P5k-ps5/p5k-ps5/app/fuentes/LEEME.md

# Fuentes de la interfaz

Recortes al español de **Inter Tight** y **Geist Mono**, las mismas de NeuroClaude, generados con
`herramientas/fuentes.py`. Las dos tienen licencia [SIL Open Font License 1.1](https://openfontlicense.org);
el aviso de copyright y la licencia viajan dentro de cada fuente, en sus metadatos.

- `app/fuentes/*.ttf`: las carga la app de Mac.
- `escritorio/ui/fuentes/*.woff2`: las carga el instalador.
- `app/Pagina.swift`: las mismas woff2 en base64, porque la página no tiene internet garantizado.
