P5k-ps5/p5k-ps5/caja/compacta/vistas.png

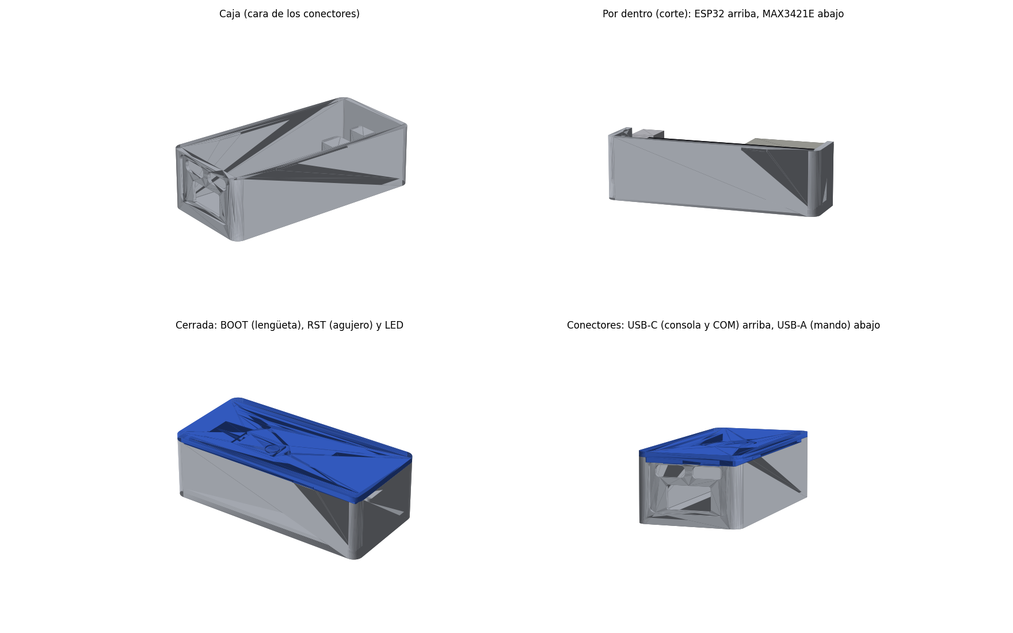
caja/compacta/vistas.png
