P5k-ps5/p5k-ps5/caja/placa/vistas.png

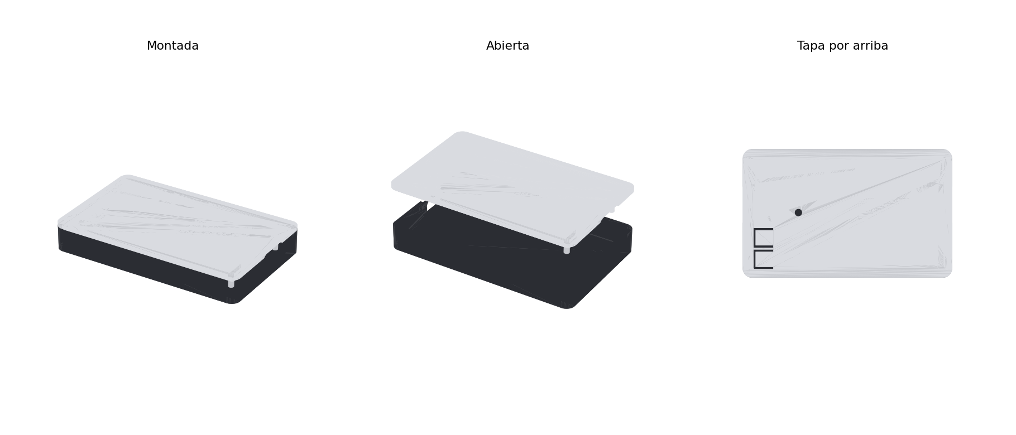
caja/placa/vistas.png
