P5k-ps5/p5k-ps5/placa/fabricacion/puente-bom.csv

Comment | Designator | Footprint | LCSC Part #
22u | C1,C2,C12,C15 | C_0805_2012Metric | C45783
100n | C3,C5,C7,C8,C13 | C_0402_1005Metric | C1525
1u | C4,C6,C9 | C_0402_1005Metric | C52923
20p | C10,C11 | C_0402_1005Metric | C1554
10u | C14 | C_0603_1608Metric | C19702
WS2812B-2020-V6 | D1 | LED_WS2812B-2020_PLCC4_2.0x2.0mm | C52917434
1N4148W | D2 | D_SOD-123 | C81598
CONSOLA/MANDO | J1,J2 | USB_C_Receptacle_HRO_TYPE-C-31-M-12 | C165948
AO3401A | Q1 | SOT-23 | C15127
2N7002 | Q2 | SOT-23 | C8545
10k | R1,R2,R3,R4,R10,R12,R15 | R_0402_1005Metric | C25744
33 | R5,R6 | R_0402_1005Metric | C25105
56k | R7,R8 | R_0402_1005Metric | C25796
100k | R9,R11 | R_0402_1005Metric | C25741
5.1k | R13,R14 | R_0402_1005Metric | C25905
BOOT/RST | SW1,SW2 | SW_Push_1P1T_XKB_TS-1187A | C318884
ESP32-S3-WROOM-1-N16R8 | U1 | ESP32-S3-WROOM-1 | C2913202
MAX3421EETJ+T | U2 | TQFN-32-1EP_5x5mm_P0.5mm_EP3.1x3.1mm | C1870151
AMS1117-3.3 | U3 | SOT-223-3_TabPin2 | C6186
USBLC6-2SC6 | U4 | SOT-23-6 | C7519
12MHz | Y1 | Crystal_SMD_3225-4Pin_3.2x2.5mm | C9002
