P5k-ps5/p5k-ps5/caja/compacta/caja-base.stl

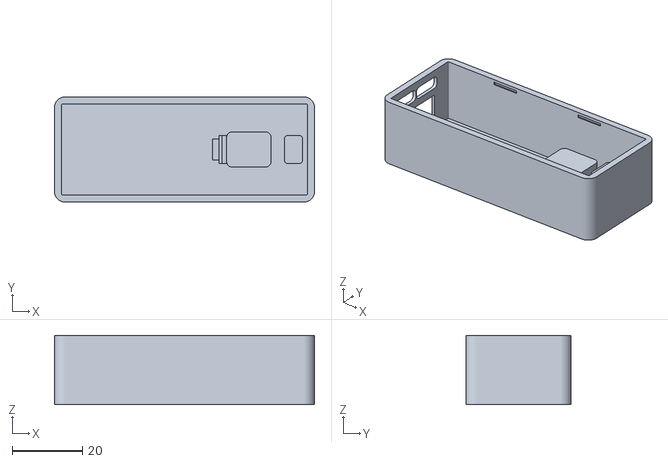
[picture p4: CAD file, 2026-11-11]
caja/compacta/caja-base.stl
74.1 x 30.0 x 19.8
