P5k-ps5/p5k-ps5/caja/conectable/caja-tapa.stl

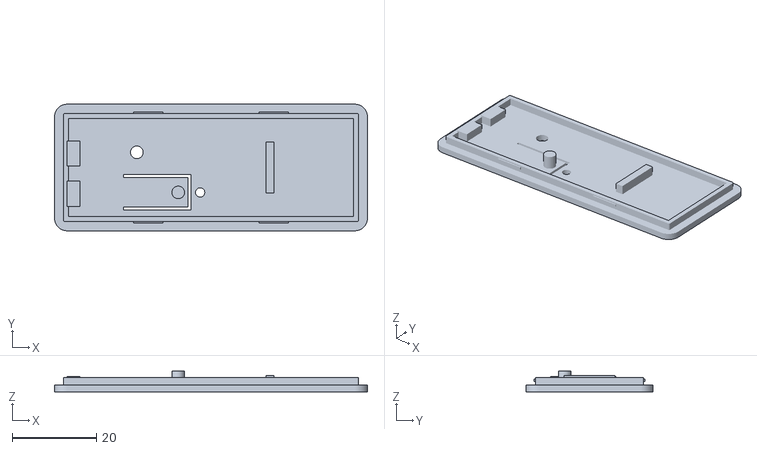
[picture p5: CAD file, 2026-11-11]
caja/conectable/caja-tapa.stl
74.1 x 30.0 x 4.90
