P5k-ps5/p5k-ps5/caja/placa/caja-tapa.stl

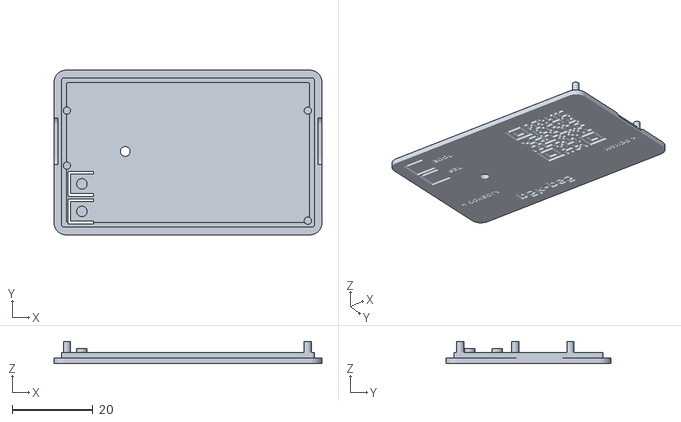
[picture p6: CAD file, 2026-11-11]
caja/placa/caja-tapa.stl
66.2 x 40.7 x 5.50
