P5k-ps5/p5k-ps5/web/descargas/modulos/caja-base.stl

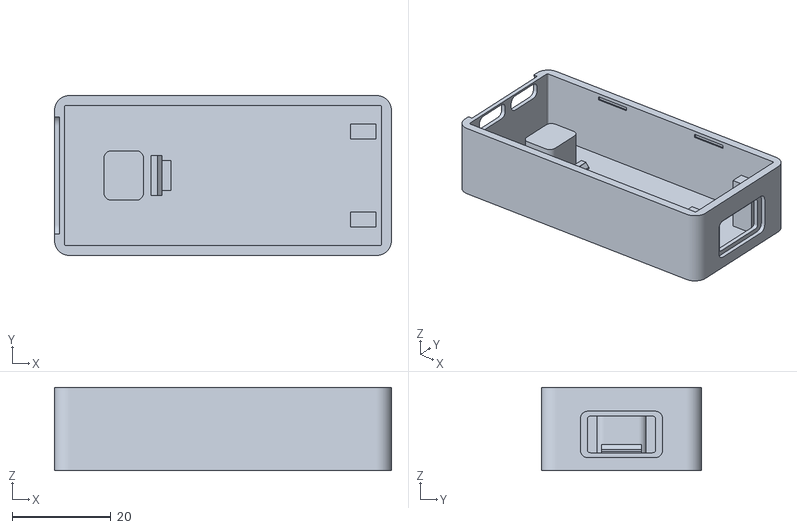
[picture p7: CAD file, 2026-11-11]
web/descargas/modulos/caja-base.stl
68.1 x 32.3 x 16.8
