P5k-ps5/p5k-ps5/web/descargas/placa/caja-base.stl

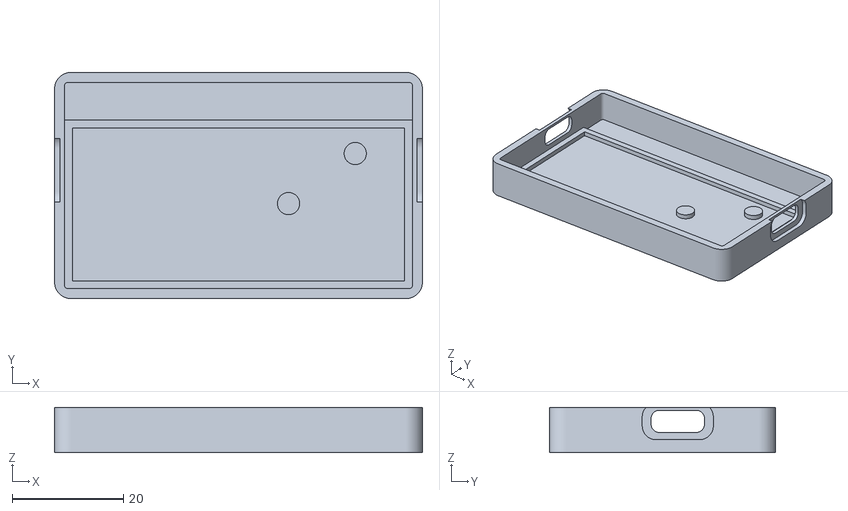
[picture p8: CAD file, 2026-11-11]
web/descargas/placa/caja-base.stl
66.2 x 40.7 x 8.10
