P5k-ps5/p5k-ps5/caja/conectable/prueba-puertos.stl

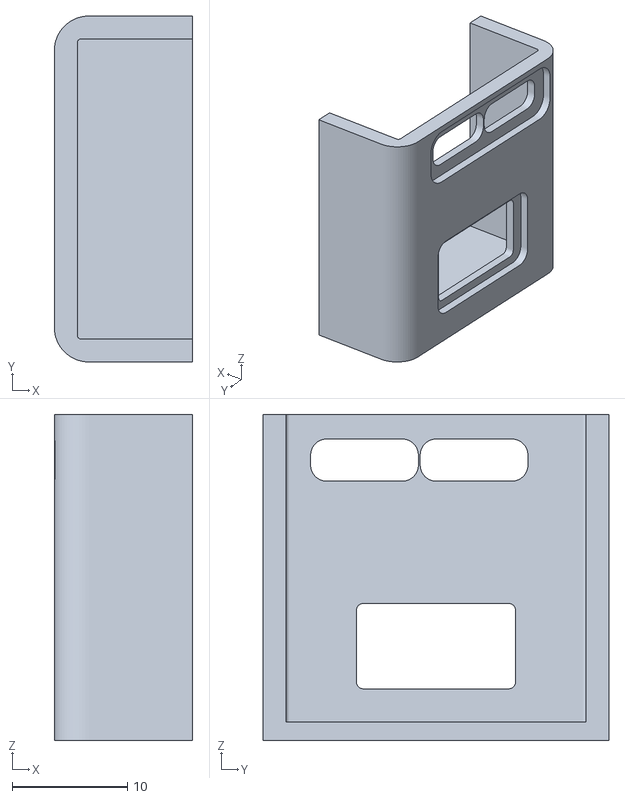
[picture p9: CAD file, 2026-11-11]
caja/conectable/prueba-puertos.stl
12.0 x 30.0 x 28.3
