P5k-ps5/p5k-ps5/web/descargas/modulos/prueba-puertos.stl

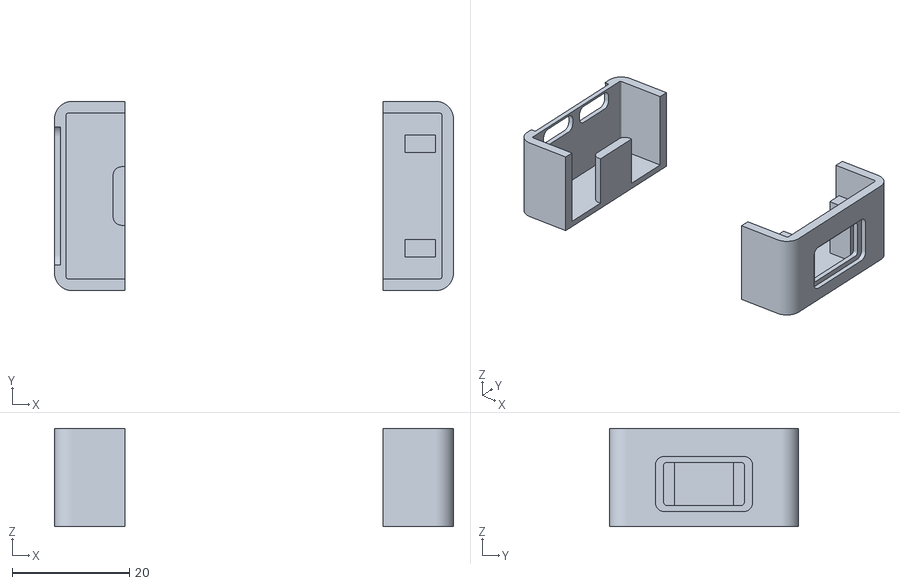
[picture p10: CAD file, 2026-11-11]
web/descargas/modulos/prueba-puertos.stl
68.1 x 32.3 x 16.8
