P5k-ps5/p5k-ps5/caja/compacta/prueba-puertos.stl

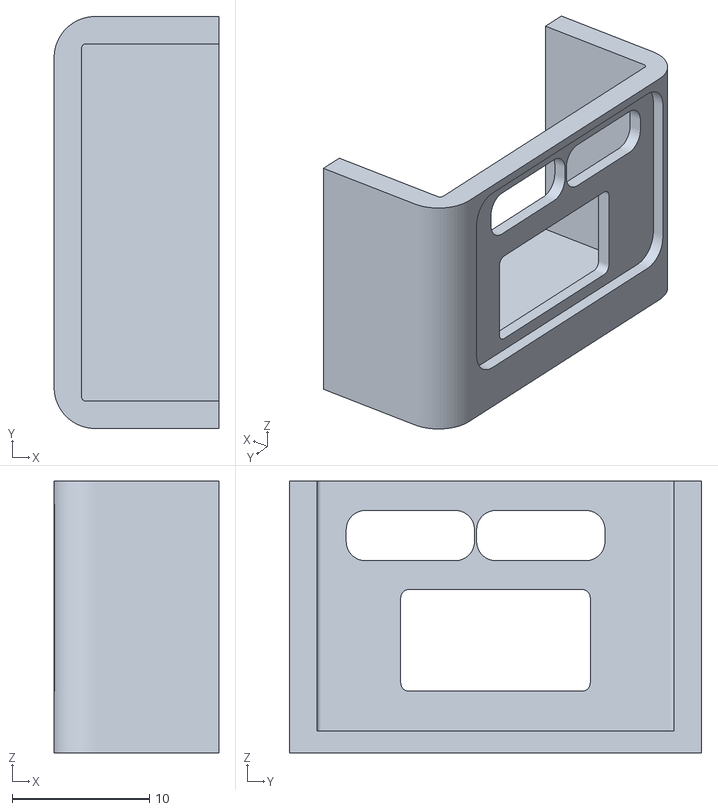
[picture p11: CAD file, 2026-11-11]
caja/compacta/prueba-puertos.stl
12.0 x 30.0 x 19.8
