P5k-ps5/p5k-ps5/caja/conectable/caja-base.stl

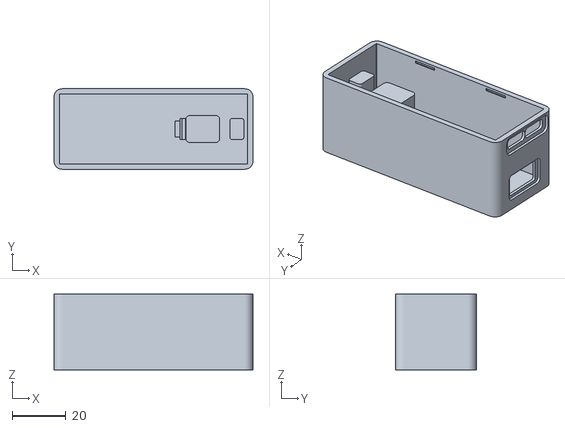
[picture p12: CAD file, 2026-11-11]
caja/conectable/caja-base.stl
74.1 x 30.0 x 28.3
