P5k-ps5/p5k-ps5/placa/puente-esquema.pdf

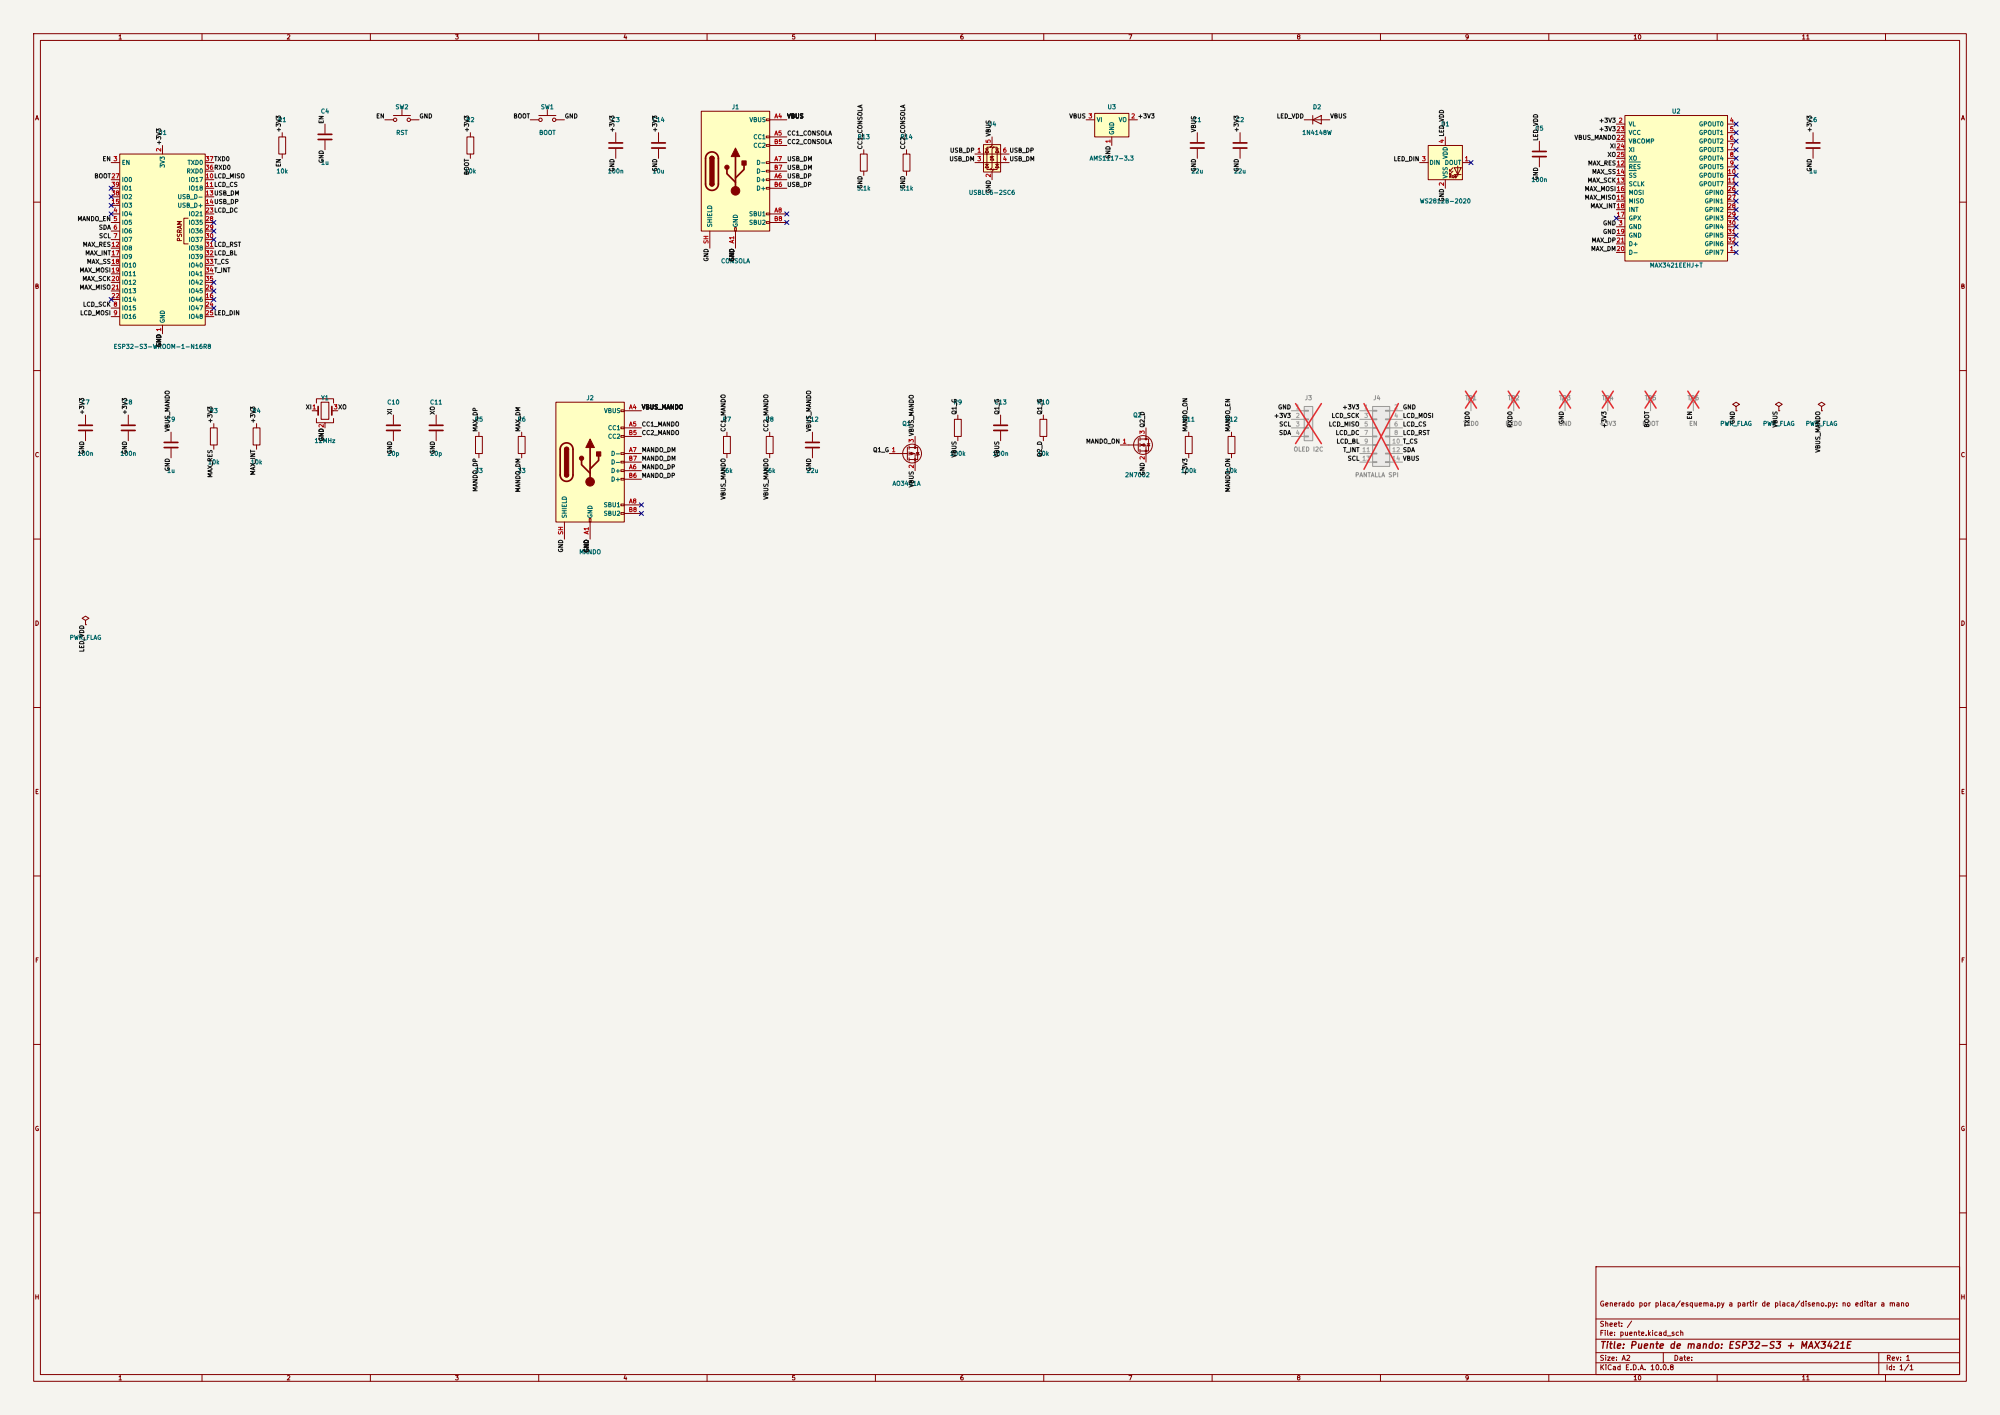
[picture p14: page 1]

Generado por placa/esquema.py a partir de placa/diseno.py: no editar a mano GND A1

Sheet: /
File: puente.kicad_sch
Title: Puente de mando: ESP32-S3 + MAX3421E

Size: A2 | Rev: 1
KiCad E.D.A. 10.0.8 | Id: 1/1
