P5k-ps5/p5k-ps5/placa/puente.kicad_pcb

## KiCad design placa/puente.kicad_pcb (2026-11-12)

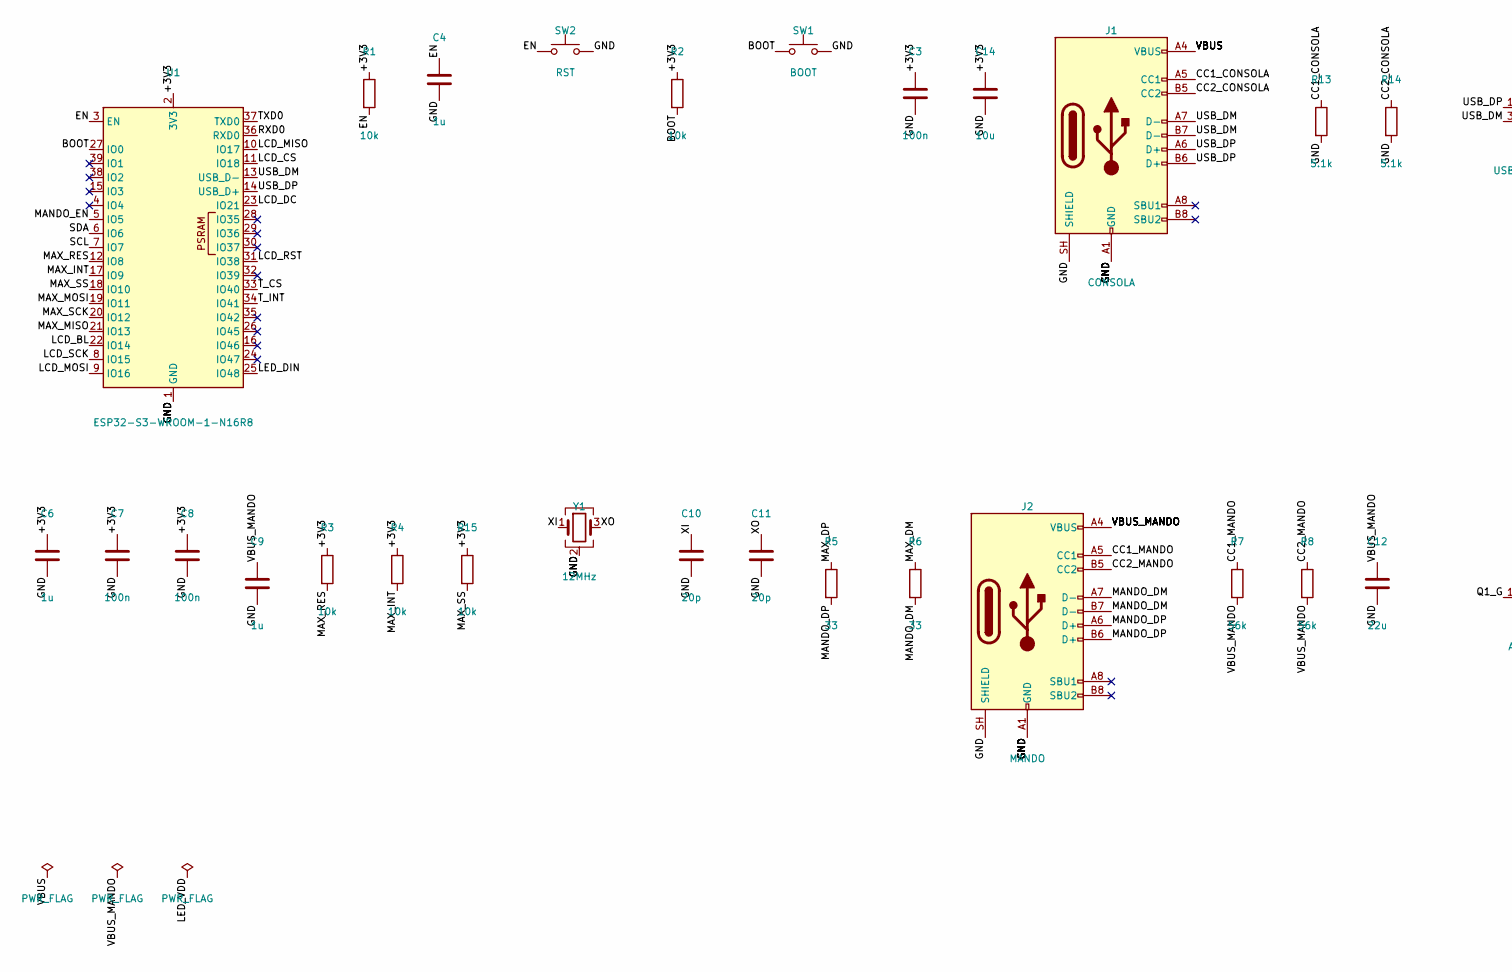
[picture p15: schematic puente.kicad_sch, Puente de mando: ESP32-S3 + MAX3421E, part in row 1, column 1]

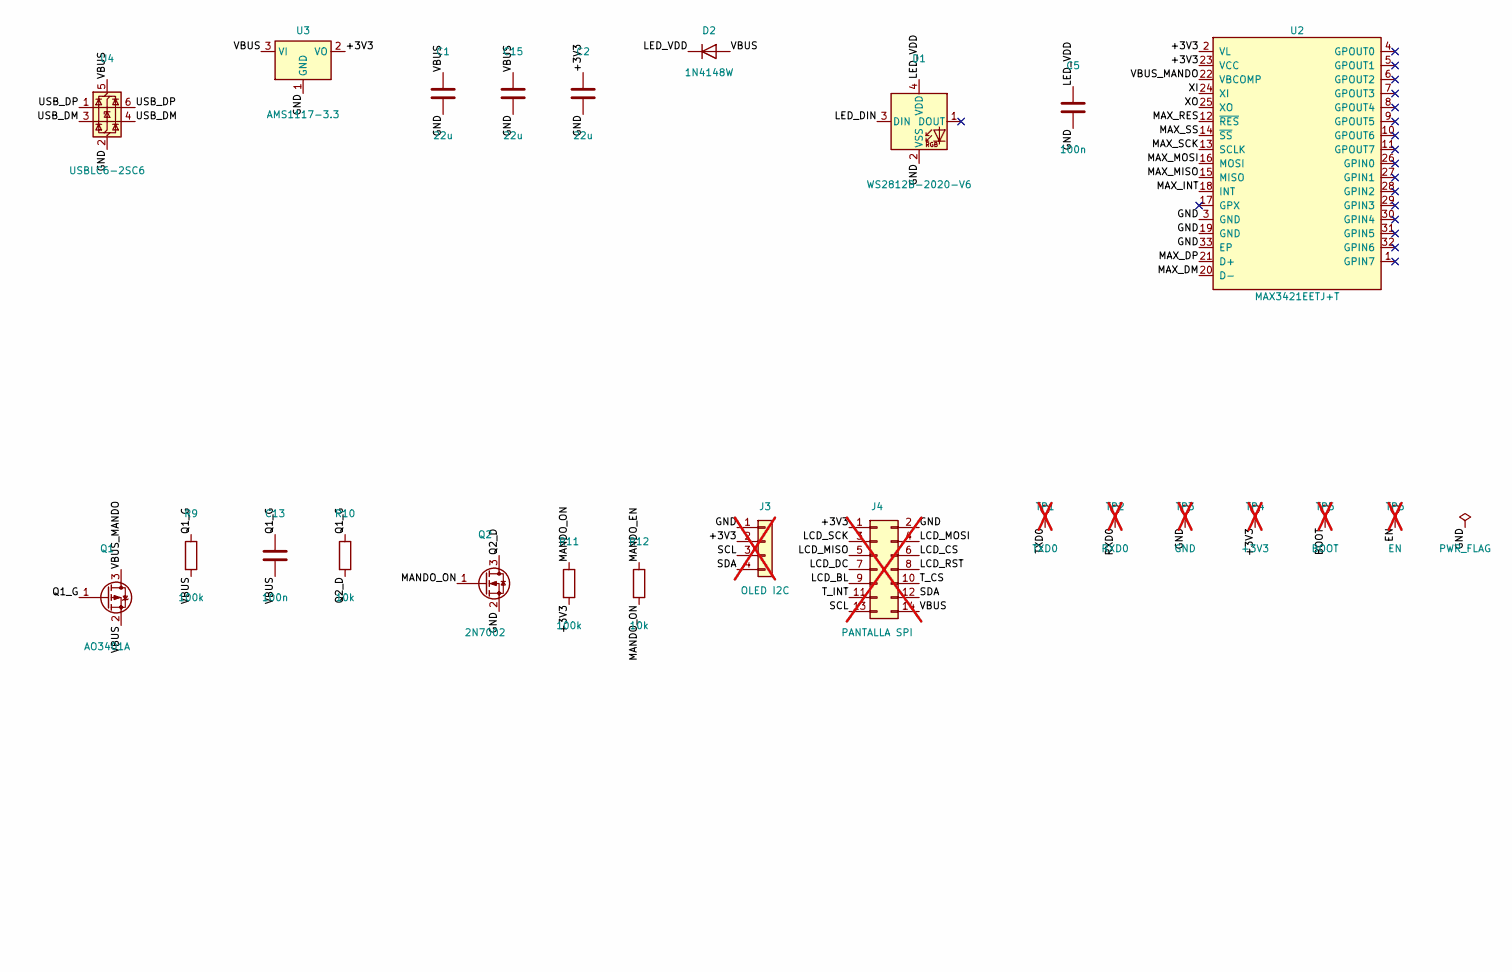
[picture p16: schematic puente.kicad_sch, Puente de mando: ESP32-S3 + MAX3421E, part in row 1, column 2]

Parts:
C1, C2, C12, C15: 22u; C_0805_2012Metric; LCSC C45783
C3, C5, C7, C8, C13: 100n; C_0402_1005Metric; LCSC C1525
C4, C6, C9: 1u; C_0402_1005Metric; LCSC C52923
C10, C11: 20p; C_0402_1005Metric; LCSC C1554
C14: 10u; C_0603_1608Metric; LCSC C19702
D1: WS2812B-2020-V6; LED_WS2812B-2020_PLCC4_2.0x2.0mm; LCSC C52917434
D2: 1N4148W; D_SOD-123; LCSC C81598
J1: CONSOLA; USB_C_Receptacle_HRO_TYPE-C-31-M-12; LCSC C165948
J2: MANDO; USB_C_Receptacle_HRO_TYPE-C-31-M-12; LCSC C165948
J3: OLED I2C; PinHeader_1x04_P2.54mm_Vertical; not fitted
J4: PANTALLA SPI; PinHeader_2x07_P2.54mm_Vertical; not fitted
Q1: AO3401A; SOT-23; LCSC C15127
Q2: 2N7002; SOT-23; LCSC C8545
R1, R2, R3, R4, R10, R12, R15: 10k; R_0402_1005Metric; LCSC C25744
R5, R6: 33; R_0402_1005Metric; LCSC C25105
R7, R8: 56k; R_0402_1005Metric; LCSC C25796
R9, R11: 100k; R_0402_1005Metric; LCSC C25741
R13, R14: 5.1k; R_0402_1005Metric; LCSC C25905
SW1: BOOT; SW_Push_1P1T_XKB_TS-1187A; LCSC C318884
SW2: RST; SW_Push_1P1T_XKB_TS-1187A; LCSC C318884
TP1: TXD0; TestPoint_Pad_D1.0mm; not fitted
TP2: RXD0; TestPoint_Pad_D1.0mm; not fitted
TP3: GND; TestPoint_Pad_D1.0mm; not fitted
TP4: +3V3; TestPoint_Pad_D1.0mm; not fitted
TP5: BOOT; TestPoint_Pad_D1.0mm; not fitted
TP6: EN; TestPoint_Pad_D1.0mm; not fitted
U1: ESP32-S3-WROOM-1-N16R8; ESP32-S3-WROOM-1; LCSC C2913202
U2: MAX3421EETJ+T; TQFN-32-1EP_5x5mm_P0.5mm_EP3.1x3.1mm; LCSC C1870151
U3: AMS1117-3.3; SOT-223-3_TabPin2; LCSC C6186
U4: USBLC6-2SC6; SOT-23-6; LCSC C7519
Y1: 12MHz; Crystal_SMD_3225-4Pin_3.2x2.5mm; LCSC C9002

Connections:
/+3V3: C2.1, C3.1, C6.1, C7.1, C8.1, C14.1, J3.2, J4.1, R1.1, R2.1, R3.1, R4.1, R11.2, R15.1, TP4.1, U1.2 (3V3), U2.2 (VL), U2.23 (VCC), U3.2 (VO)
/BOOT: R2.2, SW1.1, TP5.1, U1.27 (IO0)
/CC1_CONSOLA: J1.A5 (CC1), R13.1
/CC1_MANDO: J2.A5 (CC1), R7.1
/CC2_CONSOLA: J1.B5 (CC2), R14.1
/CC2_MANDO: J2.B5 (CC2), R8.1
/EN: C4.1, R1.2, SW2.1, TP6.1, U1.3 (EN)
/GND: C1.2, C2.2, C3.2, C4.2, C5.2, C6.2, C7.2, C8.2, C9.2, C10.2, C11.2, C12.2, C14.2, C15.2, D1.2 (VSS), J1.A1 (GND), J1.A12 (GND), J1.B1 (GND), J1.B12 (GND), J1.SH (SHIELD), J2.A1 (GND), J2.A12 (GND), J2.B1 (GND), J2.B12 (GND), J2.SH (SHIELD), J3.1, J4.2, Q2.2 (S), R13.2, R14.2, SW1.2, SW2.2, TP3.1, U1.1 (GND), U1.40 (GND), U1.41 (GND), U2.3 (GND), U2.19 (GND), U2.33 (EP), U3.1 (GND), U4.2 (GND), Y1.2 (G), Y1.4 (G)
/LCD_BL: J4.9, U1.22 (IO14)
/LCD_CS: J4.6, U1.11 (IO18)
/LCD_DC: J4.7, U1.23 (IO21)
/LCD_MISO: J4.5, U1.10 (IO17)
/LCD_MOSI: J4.4, U1.9 (IO16)
/LCD_RST: J4.8, U1.31 (IO38)
/LCD_SCK: J4.3, U1.8 (IO15)
/LED_DIN: D1.3 (DIN), U1.25 (IO48)
/LED_VDD: C5.1, D1.4 (VDD), D2.1 (K)
/MANDO_DM: J2.A7 (D-), J2.B7 (D-), R6.2
/MANDO_DP: J2.A6 (D+), J2.B6 (D+), R5.2
/MANDO_EN: R12.1, U1.5 (IO5)
/MANDO_ON: Q2.1 (G), R11.1, R12.2
/MAX_DM: R6.1, U2.20 (D-)
/MAX_DP: R5.1, U2.21 (D+)
/MAX_INT: R4.2, U1.17 (IO9), U2.18 (INT)
/MAX_MISO: U1.21 (IO13), U2.15 (MISO)
/MAX_MOSI: U1.19 (IO11), U2.16 (MOSI)
/MAX_RES: R3.2, U1.12 (IO8), U2.12 (~RES)
/MAX_SCK: U1.20 (IO12), U2.13 (SCLK)
/MAX_SS: R15.2, U1.18 (IO10), U2.14 (~SS)
/Q1_G: C13.1, Q1.1 (G), R9.1, R10.1
/Q2_D: Q2.3 (D), R10.2
/RXD0: TP2.1, U1.36 (RXD0)
/SCL: J3.3, J4.13, U1.7 (IO7)
/SDA: J3.4, J4.12, U1.6 (IO6)
/TXD0: TP1.1, U1.37 (TXD0)
/T_CS: J4.10, U1.33 (IO40)
/T_INT: J4.11, U1.34 (IO41)
/USB_DM: J1.A7 (D-), J1.B7 (D-), U1.13 (USB_D-), U4.3 (I/O2), U4.4 (I/O2)
/USB_DP: J1.A6 (D+), J1.B6 (D+), U1.14 (USB_D+), U4.1 (I/O1), U4.6 (I/O1)
/VBUS: C1.1, C13.2, C15.1, D2.2 (A), J1.A4 (VBUS), J1.A9 (VBUS), J1.B4 (VBUS), J1.B9 (VBUS), J4.14, Q1.2 (S), R9.2, U3.3 (VI), U4.5 (VBUS)
/VBUS_MANDO: C9.1, C12.1, J2.A4 (VBUS), J2.A9 (VBUS), J2.B4 (VBUS), J2.B9 (VBUS), Q1.3 (D), R7.2, R8.2, U2.22 (VBCOMP)
/XI: C10.1, U2.24 (XI), Y1.1
/XO: C11.1, U2.25 (XO), Y1.3

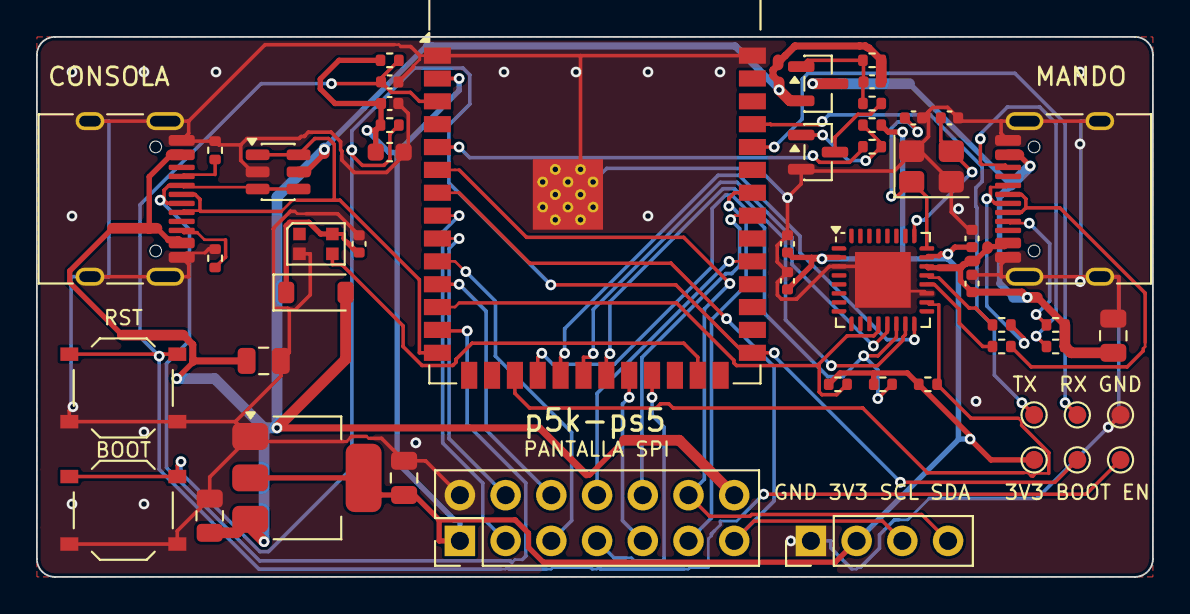
[picture p17: board puente.kicad_pcb from above]

Board: 2 copper layers, 62.0 x 30.0 mm, 51 parts (0 on the bottom side), 43 nets.
