P5k-ps5/p5k-ps5/main/dualsense_descriptores.h

// Descriptores USB y feature reports del DualSense (PS5), capturados byte a byte de un mando real
// (VID 054C / PID 0CE6, fw 0x0110002a) con libusb/hidapi. Para que el ESP32-S3 se presente a la PS5
// EXACTAMENTE como un DualSense. NO reconstruidos a mano: son los bytes reales del dispositivo, salvo los datos
// que identifican al mando y a la consola (direcciones Bluetooth, número de serie, emparejamiento), sustituidos
// por valores ficticios. Estos informes fijos solo se usan sin mando real (con el mando en el MAX3421E se le
// piden a él), y sin mando real la PS5 no acepta la autenticación de todas formas.
#pragma once
#include <stdint.h>

static const uint8_t ds_descriptor_dispositivo[18] = {
    0x12, 0x01, 0x00, 0x02, 0x00, 0x00, 0x00, 0x40, 0x4c, 0x05, 0xe6, 0x0c,
    0x00, 0x01, 0x01, 0x02, 0x00, 0x01,
};

static const uint8_t ds_descriptor_configuracion[227] = {
    0x09, 0x02, 0xe3, 0x00, 0x04, 0x01, 0x00, 0xc0, 0xfa, 0x09, 0x04, 0x00,
    0x00, 0x00, 0x01, 0x01, 0x00, 0x00, 0x0a, 0x24, 0x01, 0x00, 0x01, 0x49,
    0x00, 0x02, 0x01, 0x02, 0x0c, 0x24, 0x02, 0x01, 0x01, 0x01, 0x06, 0x04,
    0x33, 0x00, 0x00, 0x00, 0x0c, 0x24, 0x06, 0x02, 0x01, 0x01, 0x03, 0x00,
    0x00, 0x00, 0x00, 0x00, 0x09, 0x24, 0x03, 0x03, 0x01, 0x03, 0x04, 0x02,
    0x00, 0x0c, 0x24, 0x02, 0x04, 0x02, 0x04, 0x03, 0x02, 0x03, 0x00, 0x00,
    0x00, 0x09, 0x24, 0x06, 0x05, 0x04, 0x01, 0x03, 0x00, 0x00, 0x09, 0x24,
    0x03, 0x06, 0x01, 0x01, 0x01, 0x05, 0x00, 0x09, 0x04, 0x01, 0x00, 0x00,
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
    0x00, 0x00, 0x00, 0x00,
};
static const uint8_t ds_feat_85[3] = {
    0x85, 0x00, 0xff,
};
static const uint8_t ds_feat_e0[64] = {
    0xe0, 0x00, 0x00, 0x00, 0x00, 0x00, 0x00, 0x00, 0x00, 0x00, 0x00, 0x00,
    0x06, 0x00, 0x00, 0x00, 0x00, 0x00, 0x00, 0x00, 0x00, 0x00, 0x00, 0x00,
    0x00, 0x00, 0x00, 0x00, 0x00, 0x00, 0x00, 0x00, 0x00, 0x00, 0x00, 0x00,
    0x00, 0x00, 0x00, 0x00, 0x00, 0x00, 0x00, 0x00, 0x00, 0x00, 0x00, 0x00,
    0x00, 0x00, 0x00, 0x00, 0x00, 0x00, 0x00, 0x00, 0x00, 0x00, 0x00, 0x00,
    0x00, 0x00, 0x00, 0x00,
};

typedef struct { uint8_t id; const uint8_t *datos; uint16_t largo; } ds_feature_t;
static const ds_feature_t ds_features[] = {
    { 0x05, ds_feat_05, sizeof(ds_feat_05) },
    { 0x09, ds_feat_09, sizeof(ds_feat_09) },
    { 0x0b, ds_feat_0b, sizeof(ds_feat_0b) },
    { 0x20, ds_feat_20, sizeof(ds_feat_20) },
    { 0x22, ds_feat_22, sizeof(ds_feat_22) },
    { 0x81, ds_feat_81, sizeof(ds_feat_81) },
    { 0x83, ds_feat_83, sizeof(ds_feat_83) },
    { 0x85, ds_feat_85, sizeof(ds_feat_85) },
    { 0xe0, ds_feat_e0, sizeof(ds_feat_e0) },
};
