P5k-ps5/p5k-ps5/(commit log)

2026-11-11 p5k-ps5: puente entre el DualSense y la PS5 con ESP32-S3 y MAX3421E
    Firmware, app de escritorio, placa propia para JLCPCB, caja imprimible y web.
    Licencia GPL-3.0.
    [caja-base.stl, caja-tapa.stl, partitions.csv, prueba-puertos.stl, puente-bom.csv, puente.kicad_pcb, puente.kicad_sch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]
2026-11-11 Web: demo de la app, instalador desde el navegador y estado del proyecto
    - Demo interactiva de la app real con un simulador de la placa (herramientas/demo.py, web/demo/)
    - Instalador con ESP Web Tools y el firmware compilado de este repositorio (web/firmware/)
    - Tablero de lo que funciona y lo que no, mapa del repositorio y créditos
    - App de escritorio: graba con la tabla de particiones OTA (otadata en 0xf000, app en 0x20000)
    - DESIGN.md al día con los componentes nuevos
2026-11-11 Web: plano de cableado del montaje con módulos
    El montaje probado va con cables Dupont: la ficha y la guía lo dicen, y el hueco bajo la ficha
    lleva el plano de los 9 cables. Inter Tight y Geist Mono quedan como excepción del detector.
2026-11-11 Web nueva: DualSense 3D en tiempo real y mundo visual propio
    - El mando en 3D (three.js, sin modelos descargados) gira, se ilumina por zonas y se desmonta con el scroll
    - Página de producto con Schibsted Grotesk, Martian Mono y un naranja de señal
    - La demo ya no desplaza la página de fuera al cargar (scrollIntoView dentro del iframe)
    - DESIGN.md recoge dos sistemas: el de la app y el de la web pública
2026-11-11 Quita un registro vacío de la página de decisión
2026-11-11 Web: el DualSense 3D calcado de una foto de frente del mando
    Carcasa, núcleo negro, gatillos, barras de luz y la posición de cada pieza salen de los contornos
    de la foto (web/dualsense-datos.js); bisel con sombreado suave y barras de luz en el azul real.
2026-11-11 Web: el DualSense 3D es ahora un modelo real (CC BY 4.0)
    «Playstation 5 Dualsense» de AHarmlessPotato (Sketchfab), con las texturas reducidas para la web
    (web/modelo/, con su licencia). Las zonas se iluminan con un foco sobre la superficie y en «Por dentro»
    el mando se vuelve translúcido y enseña la placa. Crédito en el pie de la web.
2026-11-11 Web: en el móvil el mando se centra en el hueco libre de cada parada
    Mide el hueco entre la barra y el título (o entre el titular y el texto en la portada) y ajusta
    posición y tamaño; en pantallas bajas el texto se compacta.
2026-11-11 Web: tamaños de la escala en móviles bajos
2026-11-11 Web: el hardware va fuera del mando, unido por cable
    - La placa p5k-ps5 en 3D exportada de KiCad (web/modelo/placa.glb), con las piezas que no tienen modelo
    en la biblioteca (USB-C, MAX3421E, botones, LED) en las coordenadas del diseño
    - El montaje con módulos (YD-ESP32-S3 + MAX3421E mini) con las medidas de caja/caja.py y los nueve
    cables Dupont con sus colores
    - Las dos últimas paradas enseñan cada uno fuera del mando, con el cable al mando y el de la consola
2026-11-11 Caja para la placa p5k-ps5 y descargas en la web
    - caja/placa_caja.py genera la caja de la placa (base y tapa sin soportes, USB-C a los lados, botones
    flexibles sobre RST y BOOT, LED, QR y textos grabados en la tapa)
    - Sección «Descargas» en la web: las dos cajas en 3D (con la placa dentro), medidas, material e impresión,
    y los STL y los archivos de JLCPCB (Gerber, BOM, CPL) para descargar desde la propia web
    [caja-base.stl, caja-tapa.stl, prueba-puertos.stl, puente-bom.csv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]
2026-11-11 DESIGN.md: tamaños, radios y color de la web que faltaban
2026-11-11 Web: en Safari el mando se quedaba abajo en el móvil
    El hueco libre de cada parada se medía con offsetTop, que en Safari cuenta desde el contenedor de todas
    las paradas; ahora se mide respecto a la propia parada.
2026-11-11 Web: la app y la actualización por WiFi, probadas
2026-11-12 Placa: MAX3421E en TQFN y LED V6, por existencias en JLCPCB
    - El MAX3421EEHJ+T (TQFP) está agotado: pasa al MAX3421EETJ+T (TQFN-32 5x5, C1870151), con el mismo
    patillaje y la almohadilla de debajo a masa. Huella nueva, trazado y DRC limpios
    - LED WS2812B-2020-V6 (C52917434), mismo encapsulado
    - BOM con una línea por pieza: JLCPCB no acepta dos líneas con la misma pieza (J1/J2, SW1/SW2)
    [puente-bom.csv, puente.kicad_pcb, puente.kicad_sch]
2026-11-12 Placa: CPL corregido para el visor de JLCPCB
    El ESP32-S3-WROOM-1 (3,4 mm más abajo), el MAX3421E en TQFN (-90°) y el 1N4148W (180°) salían
    desplazados o girados en el visor de montaje de JLCPCB; las correcciones van en fabricacion.py.
    [puente-cpl.csv]
