P5k-ps5/p5k-ps5/(notices)

Notices in the files:
placa/puente.kicad_pcb:
GPL-3.0 · placa rev 1
